minepedro/testes/docs/avaliacao-carrinho.md

# Avaliação do carrinho (Mercado Livre)

Feita só pelos nomes dos anúncios: o Mercado Livre bloqueia a leitura das páginas
daqui, então **não confirmei conteúdo nem preço de cada item**. Total do carrinho
informado: R$ 1.792,47 (sem o TPU e sem o kit de bornes banana, que ficaram desmarcados).

Já tem: ferro de solda e estanho.

## Tirar
| Item | Motivo |
|---|---|
| Ferro de solda Exbom 60W | Você já tem. Se o seu for sem ajuste de temperatura, 60W ajustável ainda é bom, mas não é necessário. |
| Estanho 63/37 0,5 mm | Você já tem. Confira só se é com fluxo e fino (0,5 a 0,8 mm). |
| Luminária com lupa e ring light | Repete a lupa com garras (terceira mão). Fique com uma. |
| Analisador lógico 8 canais | Não é necessário agora. Só vale se o SPI ou o I2S falharem de um jeito que o multímetro não explica. Dá para comprar depois. |
| Kit estilete de precisão 13 peças | Sobrepõe o kit de limas e o de chaves. Opcional. |
| Tapete antiestático | Conforto, não necessidade. Opcional. |

## Manter (correção)
Amplificador MAX98357A, alto-falante 3W e capacitor 470 µF **ficam**. O Pedro não quer voz falada, mas quer som opcional (decisão 18). O capacitor vai no amplificador.

## Conferir antes de pagar
1. **Kit 120 jumpers:** a montagem precisa de **13 macho-fêmea** (tela) e **8 macho-macho**. Muito kit de 120 traz só macho-macho. Se o anúncio não listar as três pontas, pergunte ou troque.
2. **Placa ilhada 9×15 cm:** a caixa foi desenhada para 80×60 mm. Ela serve, mas precisa ser cortada (riscar com estilete e quebrar na quina da mesa, ou serra fina). Se achar 6×8 cm, é mais simples.
3. **Parafuso Allen M3×16:** precisa de chave **Allen 2,5 mm**. O kit de chaves de precisão pode não ter. Confira, senão compre uma chave Allen avulsa.
4. **Fluxo em pasta Mechanic UV 559:** é fluxo para solda; vale conferir se é do tipo "sem limpeza". Se não for, precisa de álcool isopropílico para limpar.
5. **Termo-retrátil:** precisa de calor (isqueiro, pistola de ar quente). O ferro não serve bem.
6. **Voltagem:** o carrinho tem item de 127 V (o ferro). Se tirar o ferro, sem problema; confira a voltagem do carregador e de qualquer outro item ligado na tomada.

## Falta
| Item | Para quê |
|---|---|
| Álcool isopropílico | Limpar o fluxo depois de soldar; sem ele a placa fica pegajosa e pode dar fuga. |
| Chave Allen 2,5 mm | Parafusos M3 da caixa (se o kit de chaves não tiver). |
| Cabo USB-C 90° (opcional) | Se a saída lateral da caixa ficar apertada. |

Para a perfboard (Parte 2 do manual), o que já está no carrinho cobre: barra fêmea (soquetes do ESP32 e da tela), barra macho, fio 26 AWG, ferro, estanho, fluxo, sugador e terceira mão.

## Quase tudo de "montagem" é opcional
- **Capacitores cerâmicos 100 nF (kit de 100):** extra do manual, off por padrão; 100 unidades é muito, mas custa pouco.
- **Botões táteis 6×6:** extra opcional.
- **Insertos M3 e parafusos:** só quando for montar a caixa; os kits (50 e 100) são grandes, mas baratos.
- **Kapton, limas, fio vermelho de 5 m:** sobra, mas são baratos e úteis na caixa e na perfboard.
