minepedro/testes/docs/compras-online.md

# Lista de compras online (Mercado Livre)

Filtre por **Full** ou entrega no dia seguinte e confira a data para o seu CEP.

## Prioridade 1: o que não funciona sem
- [ ] [ESP32-S3 N16R8](https://lista.mercadolivre.com.br/esp32-s3-n16r8) (qtd 2)
- [ ] [Tela 3,5" ST7796 SPI touch](https://lista.mercadolivre.com.br/tela-3.5-polegadas-st7796-spi-touch) (qtd 1)
- [ ] [Microfone INMP441](https://lista.mercadolivre.com.br/inmp441) (qtd 2)
- [ ] [Cabo USB-C de dados](https://lista.mercadolivre.com.br/cabo-usb-c-dados) (qtd 2)

## Prioridade 2: montagem
- [ ] [Protoboard 830 + jumpers](https://lista.mercadolivre.com.br/kit-protoboard-830-jumpers) (jumpers macho-macho **e macho-fêmea**; a montagem usa uns 22)
- [ ] [Barra de pinos macho](https://lista.mercadolivre.com.br/barra-de-pinos-macho) (para a tela, se vier sem pinos soldados)
- [ ] [Inserto de latão M3](https://lista.mercadolivre.com.br/inserto-latao-m3)

## Opcional: som (bipes e alertas, sem voz; decisão 18)
- [ ] [Amplificador MAX98357A](https://lista.mercadolivre.com.br/max98357a) (qtd 2)
- [ ] [Alto-falante 4 ohm 3 W 40 mm](https://lista.mercadolivre.com.br/alto-falante-4-ohm-3w-40mm) (qtd 2)
- [ ] [Capacitor 470 uF 10 V](https://lista.mercadolivre.com.br/capacitor-eletrolitico-470uf-10v)

## Prioridade 3: ferramentas
- [ ] [Multímetro](https://lista.mercadolivre.com.br/multimetro-digital-minipa)
- [ ] [Estanho 63/37](https://lista.mercadolivre.com.br/estanho-63-37)
- [ ] [Fluxo de solda](https://lista.mercadolivre.com.br/fluxo-de-solda-pasta)
- [ ] [Malha dessoldadora](https://lista.mercadolivre.com.br/malha-dessoldadora)
- [ ] [Kit de alicates](https://lista.mercadolivre.com.br/kit-alicate-eletronica)
- [ ] [Terceira mão com lupa](https://lista.mercadolivre.com.br/terceira-mao-solda-lupa)

## Conferir no anúncio antes de pagar
1. **ESP32:** diz "N16R8" (ou N8R8) e módulo ESP32-S3-WROOM-1. Só "ESP32 S3" pode vir sem PSRAM.
2. **Tela:** diz SPI, 480x320 e ST7796 (ou touch capacitivo). "Shield Arduino Uno" é a errada. Prefira o anúncio que informa o **chip do touch** (FT6336 ou GT911) e mostra a **ordem dos pinos**; se não mostrar, pergunte ao vendedor.
3. **Pinos da tela:** pergunte se vem **com pinos soldados** e se aceita **3,3 V**.
4. **Vendedor:** reputação verde ou MercadoLíder, com avaliações recentes confirmando que funciona.
5. **Frete:** comprar as placas do mesmo vendedor para chegar tudo junto.
