minepedro/testes/hardware/caixa/planta-caixa.html

Mascote do Claude · caixa Mini Mac

# Planta da caixa

A caixa inteira em escala, com as peças de verdade dentro: a tela, a placa ilhada com o ESP32, o alto-falante, o microfone, o botão e o LED. Confira a disposição e me diga o que mudar. Só depois eu modelo.

## De frente

A tela fica recuada numa moldura chanfrada, como no Macintosh. Embaixo, no queixo: o LED à esquerda, a gradezinha do microfone no meio e o botão à direita. O tracejado é o que fica escondido.

A janela fica no meio da caixa: a tela anda 2,3 mm para a direita porque a parte que acende não é centrada no vidro.

## Em corte, de lado

Cortada no meio, com a frente à esquerda. A placa ilhada fica deitada na bandeja, atrás e abaixo da tela; o alto-falante fica em cima, virado para a grade do topo.

Os jumpers da tela e do amplificador ficam em pé até 55,5 mm; a tela começa em 58 e o alto-falante em 106,6, então nada encosta.

## Vista de cima, na altura da placa

A placa vira com a linha V para a frente: os soquetes da tela e do microfone ficam perto da tela, e o USB-C “USB” fica na lateral direita.

Lateral direita: a fenda do cabo e a ventilação.

## Peças

Peça | Tamanho | Como imprime
Corpo: frente, topo e laterais numa peça só, com a moldura da tela, a grade do alto-falante, a fenda do USB e os trilhos da bandeja | 110 × 130 × 112 | Frente na mesa (sai fosca na texturizada), sem suporte. A peça mais demorada.
Bandeja: o fundo com os pininhos da placa e a tampa de trás, com ventilação; desliza por trás e prende com 2 parafusos M3 | 105 × 110 × 128 | Fundo na mesa, tampa em pé.
Moldura de trás da tela, como a do teste, com os 4 insertos em cima e embaixo da tela | 100 × 70 | Deitada, torres para cima.
Tecla do botão, suporte do microfone com anel de vedação, anel do alto-falante e berço do amplificador | pequenas | Juntas numa mesa; a tecla pode ir em branco.
Compras: 6 insertos M3, 4 pezinhos de borracha. Os parafusos M3 × 19 servem. | – | –

## Para você confirmar

1. Tamanho: 110 de largura, 112 de fundo e 130 de altura, perto dos 11 × 12 × 13 cm do desenho de antes.
2. Tela reta, recuada 3 mm numa moldura chanfrada. Inclinar a tela deixa a caixa mais funda e difícil de imprimir.
3. Corpo numa peça só, sem emenda na frente. A placa entra por trás, na bandeja, e sai deslizando depois de tirar o cabo USB.
4. Placa virada com a linha V para a frente, com o USB na lateral direita, a 23,5 mm do chão.
5. Insertos da tela em cima e embaixo dela, não nas laterais como no teste, para a caixa caber em 11 cm de largura. O teste continua valendo para provar o encaixe e o aperto.
