minepedro/testes/hardware/caixa/caixas-retro.html

# Caixas retrô do mascote

Dois estilos para imprimir na Bambu Lab A1, com a tela de 3,5" na frente e a placa escondida atrás. Só o visual, para escolher. As medidas são aproximadas e a gente acerta com as peças na mão.

## Mini Mac com LED, botão e extras

Os fios ficam todos por dentro e a tela fica presa atrás da moldura pelos 4 furos dela, com parafusos M3. Toque nos estados embaixo do desenho, ou use o botão laranja do próprio desenho: segure para falar e solte para mandar. Se ele estiver cochilando, 1 clique acorda.

1. 1
  LED de status, embaixo à esquerda, com uma tampinha de PLA branco que espalha a luz.
2. 2
  Botão, na frente, à direita da grade. 1 clique acorda o mascote quando ele está cochilando. Segure, fale e solte para mandar. Os pezinhos de borracha seguram a caixa quando você aperta, e o programa corta o primeiro pedacinho do áudio para não gravar o clique.
3. 3
  Alto-falante, embaixo da grade redonda do topo: um “plim” quando o Claude termina.

Ver o LED:

## Os botões que você comprou servem?

A foto ou o link do anúncio não chegaram aqui, então desenhei os tipos mais comuns. Qualquer um serve se for de pulso (solta sozinho quando você tira o dedo; no anúncio aparece como “momentâneo” ou “NA”). Botão com trava não serve. Todos ligam com 2 fios: um no GPIO 21 e outro no GND.

## Onde liga cada extra

Extra | Pino do ESP32 | Furo na placa | Mais
LED RGB (WS2812) | GPIO 47 | B7 | 3V3 e GND
Botão (acordar e falar) | GPIO 21 | B6 | GND
Alto-falante (MAX98357A) | GPIO 15, 16 e 18 | L16, L15 e L13 | 5V e GND

O LED e o botão usam pinos livres. O alto-falante divide o 15 e o 16 com o microfone: é só soldar mais um fio no mesmo furo. Correção da minha mensagem anterior: o GPIO 18 já está reservado para o alto-falante, então o LED vai no 47.

## Mini Macintosh

uns 11 × 12 × 13 cm (largura × profundidade × altura)

- Tela inclinada de leve, numa moldura funda, como os computadores dos anos 80.
- No “queixo”, embaixo da tela, uma gradezinha com o microfone logo atrás.
- O cabo USB sai por uma fenda na lateral, perto do chão.
- Os furinhos no topo ventilam o ESP32 e depois servem para o alto-falante.
- Base com degrau e pezinhos de borracha.

Filamento:

## TV de tubo

uns 15 × 10 × 18 cm com as pernas e a antena

- Tela com cantos bem arredondados e linhas de varredura, como tubo de imagem.
- Dois botões giratórios do lado: hoje enfeite, depois podem trocar de sessão de verdade.
- A grade embaixo dos botões já fica pronta para o alto-falante.
- Antena “orelha de coelho” de arame ou impressa, e pernas palito abertas.

Filamento:

## Mini Macintosh por dentro

A placa vai deitada numa bandeja no fundo, que desliza para fora por trás (como o chassi do Macintosh original). O microfone sai da placa por 6 jumpers curtos e fica preso atrás da gradezinha do queixo, vedado, virado para quem fala.

Corte de lado (a frente à esquerda). Medidas em mm, aproximadas.

A bandeja vista de cima (a frente embaixo), com a placa no lugar.

## Por que assim

- Microfone: encostado num furinho com uma arruela de EVA em volta, o som vai direto ao microfone, sem pegar o eco de dentro da caixa. Com os jumpers, a placa pode ficar onde for melhor.
- Placa deitada: a fileira com os soquetes da tela e do microfone fica para a frente, então os jumpers da tela sobem curtos até ela e os do microfone ficam com uns 5 cm.
- USB: o USB-C do ESP32 (a porta “USB”, do lado da linha L; a COM queimou) fica na beirada da placa; uma fenda na lateral, alinhada com ele, deixa gravar sem abrir nada.
- Calor e antena: o ar quente sobe para os furinhos do topo; a ponta da antena do ESP32 fica livre, sem metal perto.
- Montagem: tudo é montado na bandeja aberta, liga os jumpers, desliza para dentro e 2 parafusos atrás seguram.

## Para eu desenhar as peças de verdade, preciso de

- Os pininhos do microfone saem do mesmo lado do furinho do som ou do lado do chip?
- A placa ilhada tem furos nos cantos? Qual o diâmetro e a distância entre eles?
- A altura da placa montada: da parte de baixo das soldas até o topo do ESP32 encaixado.
- A tela: largura e altura da placa vermelha, onde fica a área da imagem e de que lado fica o conector de 14 pinos.

Para comprar: 6 jumpers macho-fêmea de 10 cm (microfone) e uma folha fina de EVA ou borracha (vedação do microfone).

As duas cabem inteiras na mesa da A1 (256 mm). A frente é impressa deitada, com a face da tela virada para a mesa texturizada, para a moldura sair lisa. As cores são as de filamentos PLA comuns.
