minepedro/testes/hardware/caixa/modelo/caixa-3d.html

Mascote do Claude · caixa v1

# Caixa Mini Mac em 3D

Gire com um dedo, aproxime com dois e toque numa peça para ver o que ela é. É o mesmo arquivo que vai para a impressora, com as peças de verdade (tela, placa, alto-falante) dentro para conferir.

Carregando o modelo (1 MB)…

3/4 Frente Lado do USB Trás Cima

110 × 112 × 130 mmgrade de 10 mm

Corpo transparente Peças de verdade MontadaSeparada

Toque numa peça

Com o corpo transparente dá para tocar nas peças de dentro.

## Ainda não imprima a caixa

Faltam duas coisas. A primeira é o resultado do terceiro teste da tela, com a placa apoiada só nos 4 cantos. A segunda são três medidas que ainda são chute. Como a entrada do USB-C é embutida e o plugue entra inteiro na lateral, o túnel precisa das medidas reais.

Plástico do plugue USB-C: largura × altura, comprimento | 12 × 6,5, 20
Medida J: da borda de trás da placa até o meio do USB | 25,1
Plaquinha do amplificador | 18 × 19,3

Preencha em Medidas do Mini Mac (https://claude.ai/artifact/MskuowJLJFxwNJLMU6zfgv). O comprimento do plugue também move a placa na bandeja, então o corpo e a bandeja esperam essas medidas.

## As peças

Para imprimir

De verdade, só para conferir

## O que foi conferido

Medido nos arquivos gerados, com as peças montadas no computador.

- As 5 peças estão fechadas, cada uma inteira, sem pedaço solto.
- Montadas, nenhuma invade outra nem as peças de verdade.
- A bandeja entra por trás com a placa, o ESP32 e os jumpers em cima sem bater em nada.
- A chave de fenda alcança os 4 parafusos da tela por trás, com o alto-falante e o amplificador já no lugar.
- Os parafusos de 19 mm param antes do fundo dos furos: sobram 0,4 mm na tela e 0,9 mm atrás.
- Imprime sem suporte. Os únicos pontos no ar são furos deitados (o maior é o do USB, com 7 mm de altura), as pontes de 1,8 mm das fendas e um degrau de 1 mm em volta da janela da tela.

O que não deu para conferir

- Não fatiei no Bambu Studio: o tempo, o filamento e as pontes você confere lá.
- Encaixe do plugue, dos insertos e do alto-falante só a impressão mostra.

## Como vai imprimir

caixa-corpo.3mfO corpo já deitado com a frente na mesa: a frente sai lisa, com o acabamento da placa de impressão.

caixa-bandeja-e-pecas.3mfA bandeja deitada, a moldura da tela, a tecla (com a face na mesa) e a tampa do microfone.

Para montar

- 6 insertos M3 e 6 parafusos M3 × 19: 4 na tela e 2 na tampa de trás.
- Fita dupla-face para o alto-falante, embaixo da grade do topo.
- Um anel de EVA de 1 mm entre a grade e o microfone.
- 4 pezinhos de borracha colados embaixo da bandeja.
