minepedro/testes/docs/decisoes.md

# Decisões

Formato: pergunta, resposta, motivo.

## 1. Como conversa com o mascote?
**Voz + tela touch.** Microfone e alto-falante para conversar, tela touch para navegar nas sessões.

## 2. Onde roda a inteligência?
**ESP32-S3 como terminal + ponte rodando na VPS (nuvem).** O mascote só cuida de tela, touch, mic e alto-falante; a ponte conversa com o Claude, lê as sessões e faz fala/transcrição.
Motivo: já existe servidor ligado 24h, então não precisa de Raspberry Pi (mais caro, esquenta).

## 3. Quais sessões o mascote mostra?
**As duas: Claude Code (cc.remote) e chats do claude.ai.**
- Claude Code: a ponte lê direto na VPS (fonte oficial/estável).
- claude.ai: fonte de dados ainda em aberto. Não há API oficial para conta pessoal; a Compliance API é só Enterprise. Alternativas: wrapper não oficial por cookie (frágil), export manual, extensão de Chrome.
- A fonte dos chats é software (ponte), não muda o hardware.

## 4. Como tratar os chats do claude.ai?
**v1 só Claude Code; claude.ai fica para a v2.** Método da v2 (cookie, export, extensão ou Compliance API) será escolhido depois, sem impacto no hardware.

## 5. Placa pronta ou peças avulsas?
**Peças avulsas, compradas na Santa Ifigênia.** ESP32-S3 (com PSRAM) + tela touch + microfone I2S + amplificador + alto-falante. Carcaça impressa na Bambu A1.

## 6. Qual tela?
**3,5" touch, 480x320.** Maior e mais legível para lista de sessões.
Nota de compra: preferir controlador ST7796 (RGB565, mais rápido) ao ILI9488 (18 bits, mais lento no SPI). Confirmar o tipo de touch (resistivo XPT2046 ou capacitivo) na loja.

## 7. Como acorda o mascote?
**Toque na tela (push-to-talk) na v1; palavra de ativação depois.** O ESP32-S3 suporta as duas, então o hardware não muda.

## 8. O que acontece quando fala com ele?
**B) Claude do mascote que lê e responde, e também envia comandos e aprova permissões nas sessões.**
Risco registrado: erro de transcrição de voz pode aprovar ação errada. Mitigação a definir na decisão 9.

## 9. Confirmação antes de agir
**Toque na tela para confirmar, por enquanto (provisório).** Tela mostra exatamente a ação; só executa quando o Pedro toca em Aprovar. Rever o nível de confirmação (sempre vs só ações de risco) antes da v1 final.

## 10. Alimentação
**USB-C na tomada na v1.** Bateria fica para uma v2; carcaça da v1 não precisa reservar espaço.

## 11. Voz (STT e TTS)
**Decidir depois.** Não afeta a compra de hardware. Sugestão para a ponte: manter STT e TTS atrás de uma interface simples, para trocar de provedor sem reescrever.
Atualização: a saída por voz (TTS) foi descartada na decisão 16. Só a entrada (STT) segue em aberto.

## 12. Como o mascote é fisicamente?
**É o mascote do Claude** (assumido: o bichinho laranja pixelado do Claude Code, conhecido como Clawd; confirmar). Personagem com corpo impresso na A1, tela 3,5" exibindo o personagem animado.
Nota: uso pessoal sem problema; se um dia for vender, a marca/personagem pertence à Anthropic.

## 13. Onde fica a tela no personagem?
**O mascote vive dentro da tela.** A tela exibe o mascote animado; a carcaça impressa é uma caixa/moldura simples ao redor, sem corpo mecânico.

## 14. Orçamento da v1
**Sem teto definido.** Priorizar qualidade (touch capacitivo, controlador ST7796, alto-falante decente) e comprar peças reserva.

## 15. Onde comprar
**Tudo online com entrega rápida** (Mercado Livre e similares), em vez da Santa Ifigênia, porque o Pedro está na Zona Sul e não há loja física confirmada aberta no sábado. Conferir na página do anúncio: N16R8, controlador ST7796, I2S, vendedor bem avaliado e prazo de entrega para o CEP.

## 16. Como o mascote responde?
**Por texto, na tela.** Sem voz de saída (TTS) na v1. A resposta é escrita no rodapé com a boca do mascote mexendo; um toque abre a resposta inteira para ler e rolar. Cada sessão guarda a última troca.
Impacto: o alto-falante e o amplificador MAX98357A deixam de ser necessários na v1 (ficam opcionais, para uma v2 com voz). O microfone continua, porque a entrada segue sendo por voz (push-to-talk).

## 17. Formato da caixa
**Opção A: cunha de duas peças** (moldura frontal inclinada 15° + tampa traseira, quatro pés laranja). Comparada com moldura com pé (B) e tela num pescoço (C); o pescoço com base fica como ideia para uma v2 com bateria.
A modelagem fica para depois, quando as peças chegarem e as medidas forem confirmadas com o paquímetro. Os desenhos e as medidas de projeto estão em `hardware/caixa-desenho.html`. Para a caixa, a placa universal passa a ser de **6 × 8 cm** (a de 9 × 15 cm era grande demais).

## 18. Som (sem voz)
**Sem voz falada, mas com som opcional.** O mascote faz sons curtos (bipes e melodias, como aviso de que uma sessão pede aprovação), gerados pelo próprio firmware. O MAX98357A e o alto-falante entram na montagem como **extra opcional**, não como peça de v2. Dá para montar com som mudo e ligar depois. Os pinos já estavam reservados (DIN no GPIO 18, BCLK e WS compartilhados com o microfone).
Compra: ficam o amplificador (2), o alto-falante (2) e o capacitor 470 µF no carrinho. Isso corrige a avaliação do carrinho que sugeria tirar esses itens.
Risco: compartilhar BCLK e WS entre microfone e amplificador (mesma porta I2S, entrada e saída) ainda não foi testado na placa.

## 19. Botão físico opcional
**GPIO 21 para o GND**, com o pull-up interno do ESP32 (extra A da Parte 2). Serve de apertar-para-falar ou mudo, sem depender da tela. O GPIO 21 fica no lado J3 da placa, longe dos pinos reservados (USB 19/20, flash/PSRAM 26–37).

## 20. Onde rodam as sessões que o mascote controla
**Na VPS, com o Claude Code e a assinatura do Pedro (`claude setup-token`), não na nuvem do claude.ai/code.**
Motivo: não há API documentada para um programa de fora ver ou responder pedidos de permissão das sessões da nuvem. Rodando na VPS, a ponte recebe cada pedido (comando, edição, pergunta de opção) antes de executar e espera o toque no mascote.
Desejo: ver e usar as mesmas sessões também pelo app do Claude (Remote Control). **A confirmar em teste**: o modo `claude -p` com hook "defer" (que pausa e retoma) não é uma sessão contínua, então pode não aparecer no app. Alternativa a testar: sessão interativa com Remote Control e um hook PreToolUse que espera a decisão do mascote por alguns minutos e, sem resposta, devolve "ask" (o pedido cai no app).

## 21. O que o mascote é
**Um controle remoto do Claude Code com voz e corpo.** Tudo o que o app do Claude faz numa sessão do Remote Control na VPS, o mascote também deve fazer: ver as sessões, criar sessão escolhendo repositório e branch, aprovar e recusar, escolher opções, aprovar planos e mandar mensagens. A diferença é que o mascote é controlado por voz e tem um corpo.
Respostas de texto livre dependem da voz (microfone).

## 22. Repositórios na VPS
**Todos os repositórios do GitHub do Pedro ficam disponíveis na VPS, pelo GitHub CLI (`gh`).** A ponte lista os repositórios e as branches com `gh` e clona cada um na primeira vez que uma sessão for aberta nele (não clona tudo de uma vez, para não encher o disco). O `gh` também serve de credencial do git para commit e push.

## 23. Comandos perigosos
**Só pelo app.** O mascote aprova os pedidos comuns, mas, quando o pedido é perigoso, mostra um aviso ("aprove pelo app") e não oferece o botão Aprovar. Lista inicial de perigosos: `rm -rf`, `git push --force`/`-f`, `git reset --hard`, apagar branch remota, deploy/publicação, `sudo`, mudanças em `.env` ou credenciais, e qualquer comando com `curl ... | sh`. A lista fica na ponte e pode ser ajustada.
Revisado (2026-10-15): o "ask" forçado vale só nas sessões criadas pelo mascote; nas sessões do Pedro (abertas pelo app ou à mão) decide o modo Automático. Se uma delas pedir permissão para um perigoso, o mascote mostra "aprove pelo app", sem botão.

## 24. Sessões da nuvem no mascote
**O mascote mostra as sessões do Remote Control (VPS) e também as da nuvem (claude.ai/code).**
Na lista, as da nuvem levam um ícone diferente. Nelas o mascote mostra estado e última resposta, manda mensagens (`claude -p ... --cloud`, documentado) e, **como recurso experimental desligável**, responde pedidos: aprovar/recusar, escolher opções (inclusive várias) e aprovar planos.
Esse recurso usa uma API interna não documentada do Claude Code (testado em 2026-10-11; resultados em `software/bridge/cli/README.md`): pode quebrar sem aviso. Se falhar ou estiver desligado, o pedido aparece como aviso "responda pelo app". Na nuvem não há "sempre permitir" (não comprovado), e pedidos perigosos continuam só pelo app, como na VPS (decisão 23).
Revisado em 2026-10-11: antes, a nuvem era só para ver.

## 25. Correções das decisões 20 e 22
- Decisão 20: as sessões da VPS usam o **login completo do claude.ai** na CLI (`claude` → `/login`), não `claude setup-token` (esse token só serve para chamadas ao modelo; o Remote Control exige o login).
- Decisão 22: "todos os repositórios" inclui os das organizações do Pedro (ex.: `byesolutions`), listados à parte com `gh repo list <org>`.
- Mensagens novas para sessões da VPS usam `tmux send-keys` (não documentado), só com a sessão parada e confirmando a chegada pelo hook `UserPromptSubmit`.

## 26. Voz
**Segurar a tela, falar e soltar. O ESP32 grava PCM 16 kHz e manda para a ponte, que transcreve com Whisper local na VPS (faster-whisper, modelo small, portugues).** Gratis e privado: o audio nao sai do servidor.
O texto aparece na tela antes de ir para o Claude (Enviar ou Descartar), por causa de erros de transcricao (risco da decisao 8).
- Dentro de uma sessao: o texto vira mensagem para ela.
- Na tela inicial: o texto vira a tarefa de uma sessao nova; depois escolhe repositorio e branch.

## 27. Camarim: acessórios e animações
**O mascote ganha acessórios em camadas e animações ligadas aos eventos das sessões, escolhidos numa tela "Camarim" no próprio aparelho.**
- Camadas (uma peça de cada): cabeça, olhos, bigode, boca, peito, mão, cor do corpo e fundo. A escolha fica gravada na NVS do ESP32.
- Animações: comemorar (sessão concluída), dancinha (todas concluídas), pedir aprovação, aprovado, recusado, tonto (erro), trabalhando, ouvindo, cochilo (10 min parado), cócegas (toque curto no corpo) e arrumar o bigode (sozinho, de vez em quando). No Camarim, qualquer uma pode ser tocada à mão.
- Tudo é desenhado só com retângulos, como o corpo. A prévia em `docs/camarim/index.html` é a especificação (formas, cores e tempos), e `docs/camarim/PROMPT-firmware.md` é o pedido para levar isso ao firmware.
- Firmware feito (`firmware/mascote`): acessórios, 11 animações com gatilhos reais, tela Camarim (cabide no canto superior direito) e escolha na NVS; compila sem avisos novos, ainda não testado na placa.

## 28. Caixa Mini Mac (substitui a 17)
**A caixa é um Mini Macintosh de uns 11 × 12 × 13 cm, no lugar da cunha de duas peças.** A placa ilhada (80 × 60) fica deitada numa bandeja que sai por trás; o microfone vai atrás da grade do queixo por 6 jumpers, o alto-falante embaixo da grade do topo, o botão na frente à direita da grade e um LED WS2812 de status.
- A tela fica presa por uma moldura de trás com 4 parafusos M3 em insertos de calor, por fora da placa vermelha. Os furos da tela só recebem pininhos, porque do furo até o vidro sobram menos de 3 mm.
- Antes da caixa, uma peça de teste prova o encaixe e a fixação da tela. Medidas, arquivos e pendências em `hardware/caixa/README.md`.
