minepedro/testes/hardware/caixa/medidas-mini-mac.html

Mascote do Claude · caixa Mini Mac

# Medidas do Mini Mac

Para eu desenhar a caixa no tamanho certo, meça cada peça com o paquímetro, em milímetros. Toque numa letra do desenho para ir direto ao campo dela. Tudo salva sozinho e eu leio daqui: quando terminar, é só me avisar no chat.

Pode usar vírgula (98,5). Sem paquímetro, uma régua serve: escreva o que der. Se não souber alguma, deixe em branco.

Os desenhos abrem em “Como eu entendi”: em escala, com as suas medidas. Azul é medida sua (toque no número para corrigir), cinza é conta minha e roxo é suposição. Em “Onde medir” estão as letras de cada medida.

0 de 0

Abrindo o caderno de medidas…

## Terminou?

Me avise no chat que as medidas estão prontas. Se aparecer “salvo só neste aparelho” lá em cima, copie o resumo e cole no chat.

Copiar resumo

Ver o resumo
