minepedro/testes/hardware/caixa/modelo/caixa-tecla.step

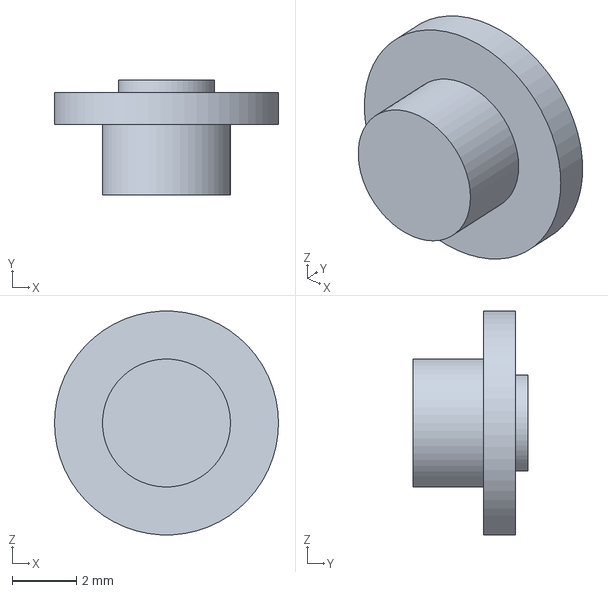
[picture p1: CAD file, 2026-10-19]
hardware/caixa/modelo/caixa-tecla.step
7.00 x 3.60 x 6.99 mm
