minepedro/testes/hardware/caixa/teste-tela/teste-tela-frente.step

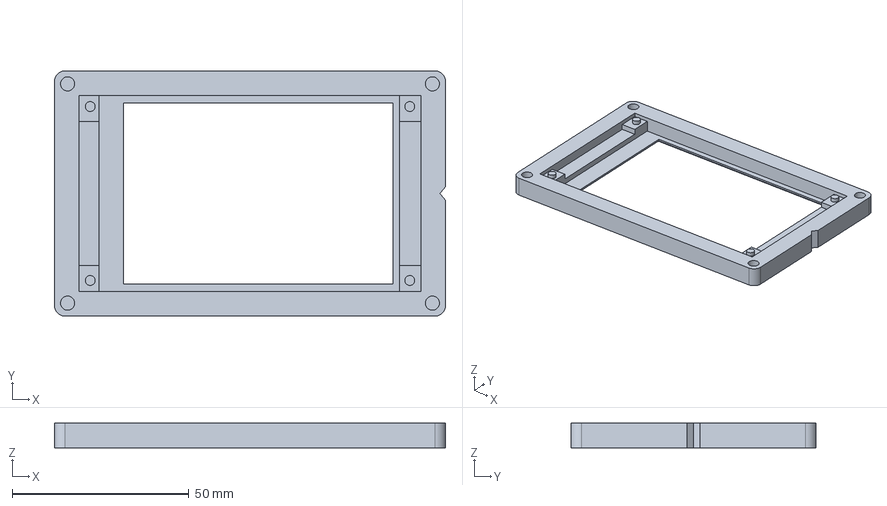
[picture p2: CAD file, 2026-10-19]
hardware/caixa/teste-tela/teste-tela-frente.step
110.6 x 69.4 x 7.00 mm
