minepedro/testes/hardware/caixa/modelo/caixa-bandeja.step

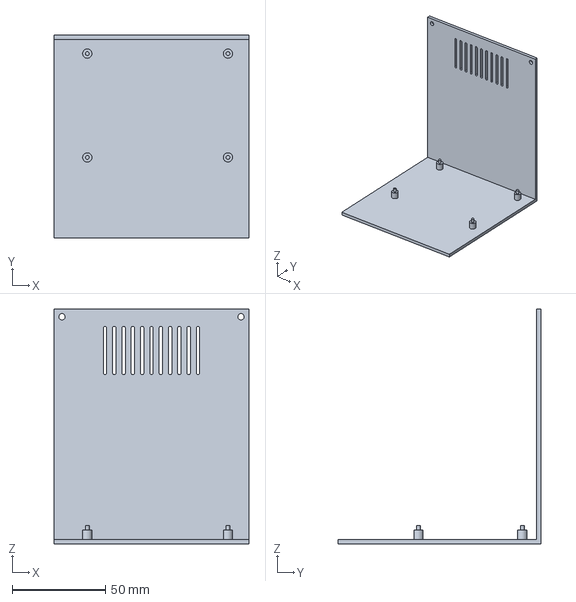
[picture p3: CAD file, 2026-10-19]
hardware/caixa/modelo/caixa-bandeja.step
104.6 x 109.3 x 126.3 mm
