minepedro/testes/hardware/caixa/teste-tela/teste-tela-tras.step

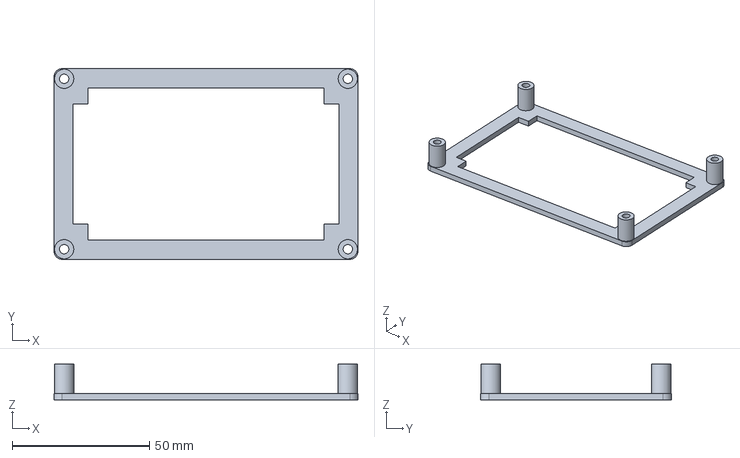
[picture p4: CAD file, 2026-10-19]
hardware/caixa/teste-tela/teste-tela-tras.step
110.6 x 69.4 x 13.0 mm
