minepedro/testes/hardware/caixa/modelo/caixa-bandeja-e-pecas.3mf

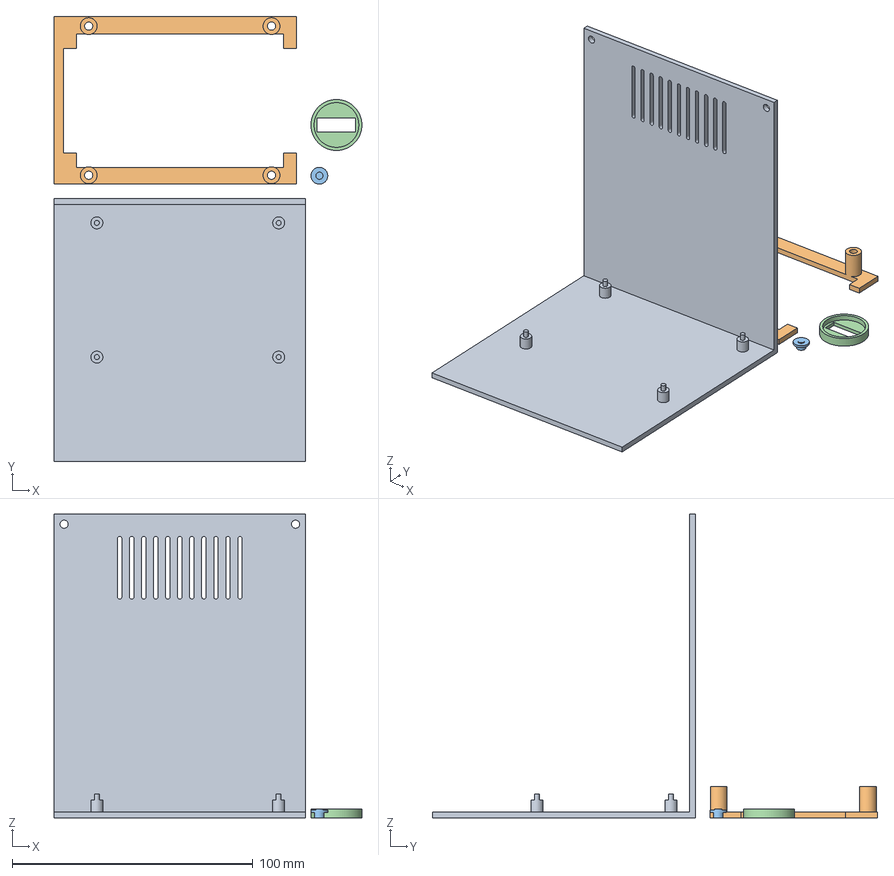
[picture p5: CAD file, 2026-10-19]
hardware/caixa/modelo/caixa-bandeja-e-pecas.3mf
128.0 x 185.0 x 126.3 mm
bandeja
moldura da tela
tecla
tampa do microfone
