minepedro/testes/hardware/caixa/teste-tela/teste-tela.step

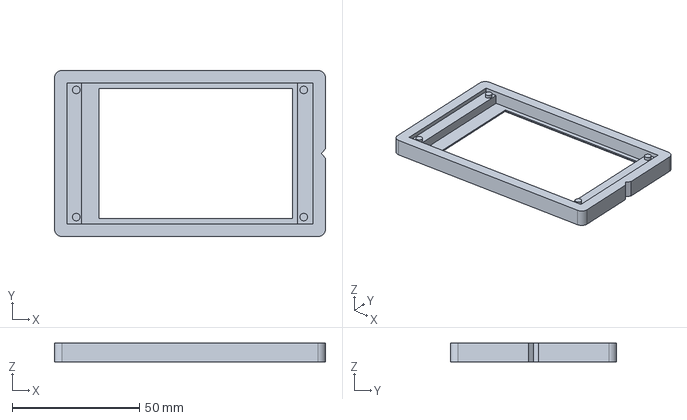
[picture p6: CAD file, 2026-10-19]
hardware/caixa/teste-tela/teste-tela.step
106.6 x 65.4 x 7.40 mm
