minepedro/testes/hardware/caixa/modelo/caixa-corpo.step

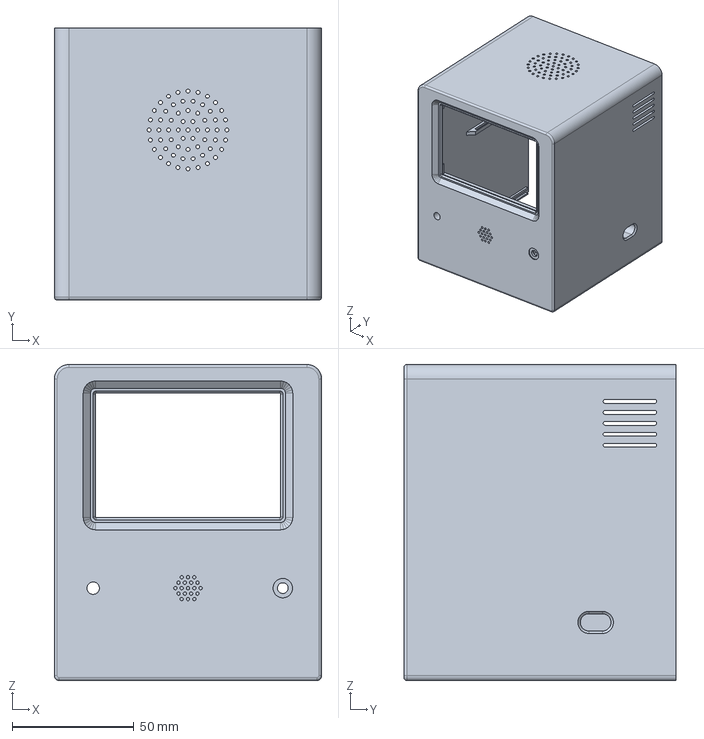
[picture p7: CAD file, 2026-10-19]
hardware/caixa/modelo/caixa-corpo.step
110.0 x 112.0 x 130.0 mm
