minepedro/testes/hardware/caixa/modelo/caixa-tampa-do-microfone.step

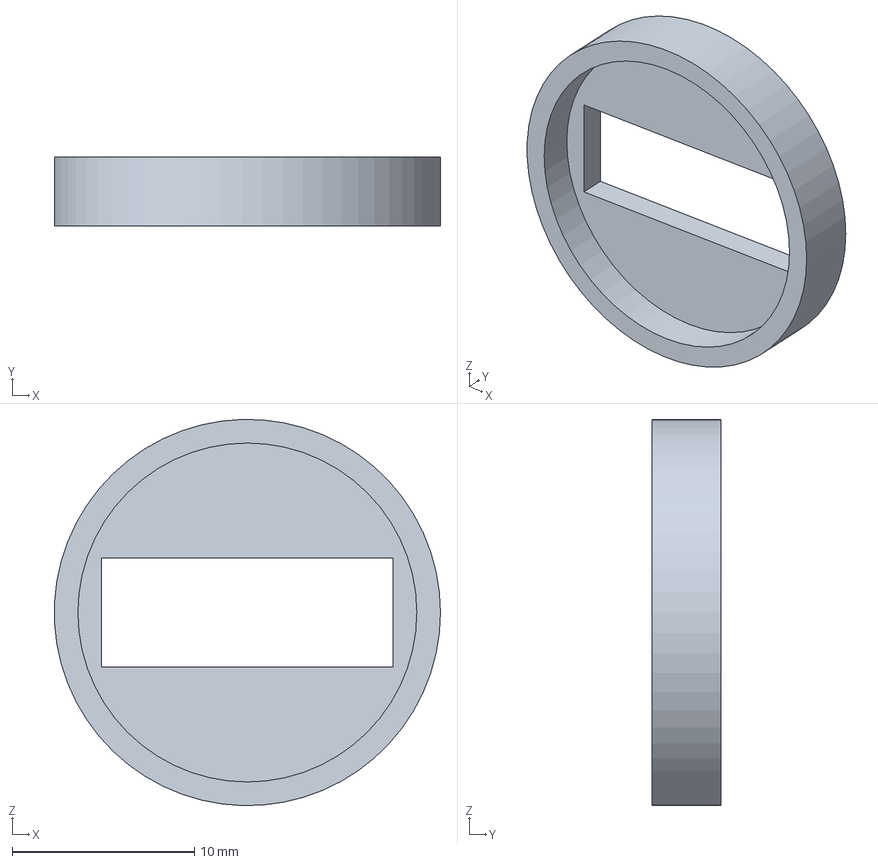
[picture p8: CAD file, 2026-10-19]
hardware/caixa/modelo/caixa-tampa-do-microfone.step
21.2 x 3.80 x 21.2 mm
