minepedro/testes/hardware/caixa/modelo/caixa-moldura-da-tela.step

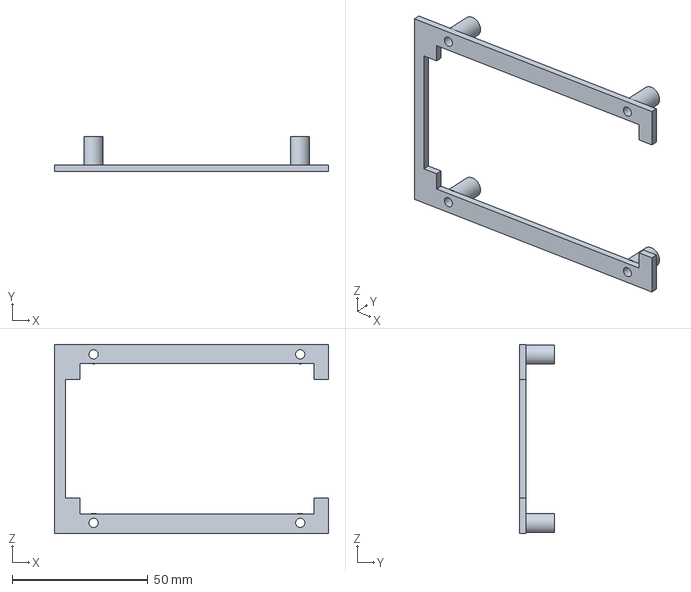
[picture p9: CAD file, 2026-10-19]
hardware/caixa/modelo/caixa-moldura-da-tela.step
100.8 x 13.0 x 69.7 mm
