minepedro/testes/(list of files, cad)

Other CAD files:
hardware/caixa/modelo/caixa-corpo.3mf
hardware/caixa/teste-tela/teste-tela.3mf
