minepedro/testes/hardware/caixa/teste-tela/croqui.html

Mascote do Claude · caixa Mini Mac

# Peça de teste da tela

Antes da caixa inteira, duas peças pequenas para provar o encaixe e a fixação da tela: a moldura da frente, com a janela, o bolso do vidro, 4 pininhos nos furos da tela e 4 insertos M3 nos cantos; e a moldura de trás, que aperta a placa com 4 parafusos M3. Esta é a terceira versão do teste: a placa apoia só nos 4 cantos e o encaixe dela tem 0,4 de folga de cada lado. Os arquivos já foram gerados com estas medidas e conferidos.

## O que muda no terceiro teste: apoio só nos 4 cantos

Você descobriu por que a placa não assentava: do lado dos pinos, as soldas do conector saem na frente da placa e batiam na faixa onde ela apoia. A largura não era o problema. Então mudam duas coisas. A placa passa a apoiar só nos 4 cantos, onde estão os pininhos, com o meio das duas faixas 2 mm mais fundo. E o encaixe da placa volta a ter folga pequena: 0,4 de cada lado, 96,8 em vez de 98,6. Em laranja, o rebaixo. Os arquivos já foram gerados com estas medidas e conferidos.

De frente, com a placa vermelha clarinha por cima e as soldas em cinza. O vidro, os pininhos e a janela continuam iguais.

Cortada ao comprido pela fileira de soldas, a metade de cima (a de baixo é igual), com a frente para baixo, como sai da impressora. A posição e a altura das soldas são estimativa.

Cortada atravessada na altura das soldas, ponta esquerda. O bolso do vidro continua com 2 mm de parede para segurar o vidro.

O mesmo corte na ponta direita. Aqui não tem solda, mas o rebaixo entra igual para os 4 cantos ficarem do mesmo jeito.

- Encaixe da placa: 96,8 de largura, com 0,4 de folga de cada lado. Em cima e embaixo continua 0,3.
- Apoios: 7 mm em cima e 7 mm embaixo, nos dois lados. Cobrem os apoios da moldura de trás (5,6), então o aperto passa reto pela placa.
- Rebaixo: 2 mm mais fundo, nos 40,8 mm do meio.
- Para medir com o paquímetro: quanto a solda mais alta sai da placa (estimei 1,5) e a distância da borda de cima da placa até a primeira solda (estimei uns 10). Se a primeira solda estiver a menos de 8 mm da borda, encurto os apoios.
- A moldura de trás não muda: qualquer uma das duas que você já imprimiu serve, porque ela aperta os cantos da placa e não depende da largura do encaixe. A caixa recebe as mesmas mudanças.

## De frente

Como você vai ver a peça, com o mascote em pé e os pinos da tela à esquerda. O tracejado é o que fica escondido atrás: os bolsos, o rebaixo das soldas, os pininhos e, em vermelho, os furos dos insertos. Medidas em mm.

A janela é a parte que acende com 0,5 mm a mais de cada lado, com um chanfro de 1 mm em volta.

## Moldura de trás

Um quadro de 2,4 mm que apoia nos 4 cantos da placa vermelha, bem em cima dos furos, e deixa o meio livre para o conector e os componentes. Os parafusos M3 passam pelas torres e entram nos insertos da frente, por fora da placa.

As torres têm 7 mm de largura e 13 mm de altura: com o M3 de 19 a ponta para antes de furar a frente. Com parafusos M3 × 8 elas não seriam necessárias.

## Em corte, pelos pininhos de cima

A peça cortada na linha dos furos de cima, com a frente para baixo, do jeito que ela sai da impressora. A tela aparece encaixada, transparente.

Ponta esquerda, lado dos pinos.

Ponta direita.

## De onde vem cada medida

O quê | Medida | Origem
Placa vermelha | 96 × 54,8 | sua 54,8 = 0,3 + 54,2 + 0,3
Encaixe da placa (por trás) | 96,8 × 55,4 × 1,4 | sua 0,4 de folga de cada lado na largura (a largura não era o problema) e 0,3 em cima e embaixo; a placa fica 0,2 para fora, para a moldura de trás apertar
Apoio da placa | 4 cantos de 7; o meio 2,0 mais fundo | seu teste as soldas do conector batiam na faixa onde a placa apoiava
Vidro: da borda da placa até o vidro | 6,1 esq. · 5,7 dir. · 0,3 cima e baixo | sua
Vidro: largura | 84,2 | sua fecha: 6,1 + 84,2 + 5,7 = 96
Bolso do vidro | 85,0 de largura, altura toda | seu teste 0,4 de folga de cada lado: o vidro entrou perfeito
Profundidade do bolso do vidro | 4,0 | conta 5,4 − 1,6 da placa = 3,8, mais 0,2 de folga
Furos da tela | Ø 3,6, a 1 mm da borda: 90,4 × 49,2 | sua antes você tinha medido 89,5 × 50
Pininhos | Ø 2,8 × 1,4 | escolha minha 0,4 de folga no furo; não passam da placa
Parte que acende | 75,2 × 50,2 | sua 2 mm do vidro na esquerda, em cima e embaixo; 7 mm na direita
Janela | 76,2 × 51,2 | escolha minha parte que acende + 0,5 de cada lado
Frente e chanfro da janela | 1,6 · 1 × 45° | escolha minha
Insertos | furo Ø 4,0 × 6,2, nos 4 cantos | suposição inserto M3 de 5,7 de comprimento e uns 4,6 por fora
Parafusos | M3 × 19 | seus por isso as torres de 13 mm na moldura de trás
Moldura de trás | 2,4 de espessura | escolha minha aperta só os cantos da placa
Borda em volta e peça | 7 · 110,6 × 69,4 × 7,0 | escolha minha 7 mm para caber o inserto nos cantos

## Como imprimir e montar

- Arquivo: teste-tela.3mf, com as duas peças já deitadas: a da frente com a face da tela na mesa, a de trás com as torres para cima. Arraste para a janela do Bambu Studio.
- Ajustes: PLA bege, camada de 0,2 mm, 4 paredes (firma o plástico em volta dos insertos), 15% de preenchimento, sem suporte.
- Insertos: com o ferro de solda a uns 220 °C, apoie o inserto no furo e deixe ele afundar sozinho, sem empurrar, até ficar rente. Embaixo do furo só tem 0,8 mm de frente: se forçar, aparece um calombo do outro lado.
- Montagem: 1) os 4 insertos na moldura da frente; 2) a tela no encaixe, com os pininhos nos furos; 3) a moldura de trás por cima; 4) os 4 parafusos M3 pelas torres, apertando só até encostar.

## Quando imprimir, confira

1. Os 4 pininhos entram nos furos sem forçar. Se não entrarem, os furos não estão a 1 mm da borda (antes você tinha medido 89,5 × 50).
2. O vidro assenta no bolso e a placa fica um tiquinho para fora atrás.
3. A placa assenta firme nos 4 cantos, sem balançar, e as soldas não encostam no fundo do rebaixo.
4. De frente, toda a parte que acende aparece, com uma bordinha escura igual em volta. Ligue o mascote para ver.
5. Depois de parafusar, a tela fica firme, a moldura de trás não entorta e nada racha em volta dos insertos.
