minepedro/testes/hardware/caixa/teste-tela/teste-tela-verificacao.pdf

# Peça de teste da tela: verificação

Medido nos arquivos gerados. Vista por trás, como sai da impressora: os pinos da tela ficam à direita aqui.

FRENTE, A 1,3 mm: JANELA E INSERTOS

FRENTE, A 4,6 mm: VIDRO E REBAIXO DAS SOLDAS

40,8

2

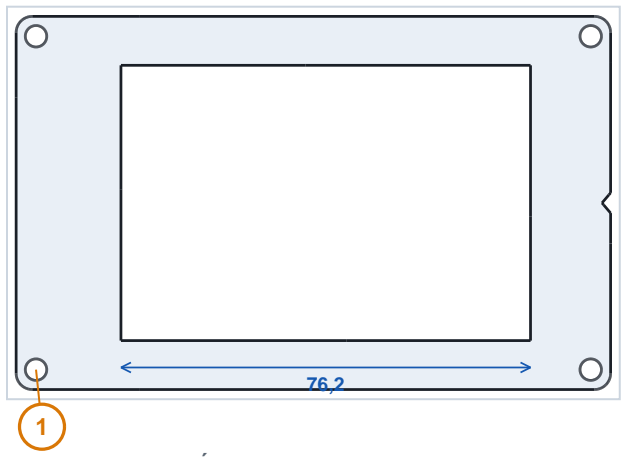
[picture p10: figure]

MOLDURA DE TRÁS, A 1,2 mm DA PLACA

3

MONTADO, PELO INSERTO DE CIMA (FRENTE EMBAIXO)

4

### 1 e 4. Insertos e parafusos

Furo de 4,0 por 6,2 nos 4 cantos, por fora da placa, com 0,8 de frente embaixo. O M3 de 19 entra pela torre da moldura de trás: a cabeça apoia a 13 mm da placa e a ponta para 0,4 antes do fundo.

### 2. Rebaixo das soldas

A placa apoia só nos 4 cantos (7 em cima e embaixo). O meio das duas faixas fica 2 mais fundo: as soldas do conector não encostam.

Pininhos
Quatro de 2,8 nos furos da tela, 90,4 x 49,2 entre centros. Alinham a placa; não seguram.

Encaixe e vidro
Encaixe da placa de -0,4 a 96,4 (96,8 x 55,4), com 0,4 de folga de cada lado. Bolso do vidro com 85, como nos testes em que o vidro entrou perfeito.

### 3. Moldura de trás

Aperta só os 4 cantos da placa, em cima dos furos; o meio fica livre para os componentes e o conector. Fica 0,2 acima da frente: o parafuso puxa e prende a placa.

Sólidos
Os dois fechados, uma casca cada. Montados, não se invadem.

Gerado por hardware/caixa/gerar_teste_tela.py. Imprimir sem suporte: a frente com a face da tela na mesa; a de trás com as torres para cima.
