minepedro/testes/(commit log)

2026-10-03 docs: decisão 2 (ESP32-S3 + ponte na VPS)
2026-10-03 docs: decisão 3 (fontes de sessões)
2026-10-03 docs: decisão 14 (sem teto de orçamento)
2026-10-03 docs: lista de compras (BOM) para Santa Ifigênia
2026-10-03 docs: guia de compras em PDF (marcas, lojas, preços estimados, ferramentas)
2026-10-03 docs: lista de compras online com links
2026-10-03 ui: protótipo web da tela (480x320) com mascote animado e push-to-talk
    Estados idle, listening, thinking e speaking numa grade de 12 px,
    pensado para virar sprites no LVGL depois.
    Claude-Session: https://claude.ai/code/session_01PC5vswkdjKx7tAHSVQQ8ss
2026-10-03 ui: sprite fiel ao Clawd do terminal (18x5, olhos e boca como buracos)
    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
2026-10-03 ui: remove a faixa de sombra que cortava o corpo do mascote
    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
2026-10-03 ui: mascote parado em todos os estados, sem anel ao ouvir, e tela de sessões
    Lista com ícone de estado, repo/branch, tempo e rolagem por arrasto;
    detalhe com última atividade e pedido de permissão pendente.
    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
2026-10-03 ui: sessão abre no mascote, aprovação, filtro por repo e nova sessão
    Mascote reage a pedido de permissão (alert) e mostra os botões
    Aprovar/Recusar na tela da sessão. Lista com filtro por repositório e
    formulário de nova sessão (repo + branch, ou avulsa). README documenta
    o que foi verificado sobre a conexão com o Claude Code.
    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
2026-10-03 ui: respostas só por texto, com leitura completa e histórico por sessão
    Decisão 16: sem voz de saída na v1. Alto-falante e amplificador
    passam a opcionais na lista de compras.
    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
2026-10-03 docs: guia de montagem real, mapa de pinos e lista de compras ajustada
    Mapa de pinos proposto para ESP32-S3 N16R8 (tela ST7796, touch I2C,
    microfone I2S), em etapas com um teste cada. Amplificador, alto-falante
    e capacitor passam para opcionais na lista online.
    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
2026-10-03 hardware: esquema visual das ligações; RESET e LED da tela vão para GPIO 6 e 7
    Todos os sinais ficam no conector esquerdo do ESP32-S3, o que simplifica
    a protoboard. Página com o caminho da conversa, o esquema com fios
    coloridos por barramento, explicação de cada grupo e checklist.
    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
2026-10-03 hardware: esquema da protoboard, lista de jumpers e etapas de teste com programas
    Vista de cima da protoboard por etapa, tabela dos 21 jumpers, lista do que
    ter na mesa e quatro programas de teste (compilam para ESP32-S3 N16R8,
    ainda não testados na placa).
    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
2026-10-04 hardware: desenhos e recomendações da caixa (cunha de duas peças)
    Três formatos comparados, vista de frente, corte lateral, layout interno
    por trás, recomendações de impressão para a Bambu A1 e lista do que medir
    quando as peças chegarem. Só desenho; medidas são propostas.
    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
2026-10-04 docs: decisão 17, caixa em cunha de duas peças (opção A)
    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
2026-10-04 hardware: página explicando visualmente cada componente da lista
    Mapa de todas as peças, caminho da energia, capacitor (com gráfico do que
    ele evita), resistor pull-up, botão tátil, barras de pinos e jumpers,
    protoboard por dentro, multímetro e ferramentas de solda.
    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
2026-10-04 Manual interativo de montagem na protoboard (Parte 1)
    40 passos em 4 etapas, peças e fios ligáveis/desligáveis, multímetro virtual
    calculado a partir do modelo de redes, previsão antes de medir, glossário,
    relatório 'Não bateu' e três vistas do circuito.
    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
2026-10-04 docs: avaliação do carrinho de compras
    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
2026-10-05 Manual interativo da placa ilhada (Parte 2) e extras de botão e som
    Placa 6x8 cm furo a furo: soquetes, barramentos, fios do verso, layout
    ajustável com avisos, defeitos simulados (ponte de solda), tabela final de
    continuidade. Extras desligados por padrão: botão (GPIO 21) e som
    (MAX98357A, capacitor, alto-falante), com programas de teste que compilam.
    Decisão 19. Parte 1 passa a linkar a Parte 2.
    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
2026-10-05 Parte 1 do manual: extras de capacitores, pull-ups, botão e som
    Quatro extras opcionais (desligados por padrão) na protoboard: capacitores
    de 100 nF, pull-ups de 4,7 kΩ no touch, botão (GPIO 21) e som (MAX98357A,
    470 µF, alto-falante). Multímetro virtual ganha o modo resistência (Ω) e o
    botão 'segurando'. Corrige o estilo do selo 'opcional' nas duas partes.
    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
2026-10-08 hardware: manual e esquema para a tela de teste ILI9488 com touch resistivo
    Touch XPT2046 em SPI próprio (SPI3) nos GPIO 9, 5, 8 e 4; T_IRQ sem ligar.
    Programa etapa2_3_tela_touch_ili9488 compila para ESP32-S3 (não testado na placa).
    Claude-Session: https://claude.ai/code/session_01SxboiigKorMT1wVqrHMahG
2026-10-08 hardware: rascunho da placa-base (PCB) do modelo final
    Esquema com rótulos de rede, posição das peças em 80 x 60 mm, redes, peças
    e regras para desenhar no EasyEDA. O conector da tela serve para a ST7796 e
    para a ILI9488 (pinos 10 a 13 nos mesmos GPIO).
    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
2026-10-11 docs: etapa 3 aprovada (touch resistivo)
    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
2026-10-11 firmware: demo do mascote na tela (ILI9488 + touch resistivo)
    Sprite, cores e estados do protótipo web: repouso, ouvindo, pensando,
    respondendo, trabalhando e alerta. Segurar a tela = ouvir; soltar = resposta
    de exemplo. Compila para ESP32-S3; não testado na placa.
    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
2026-10-11 ponte demo e firmware do mascote com lista de sessões e aprovação
    - software/bridge/ponte.py: API HTTP com token; sessões de exemplo que pedem
    permissão sozinhas; serviço systemd para a VPS.
    - firmware/mascote: Wi-Fi, tarefa de rede no núcleo 0, telas mascote, lista e
    sessão, botões Aprovar e Recusar. Compila para ESP32-S3; não testado na placa.
    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
2026-10-11 bridge/cli: prototipo de laboratorio da ponte e hook do mascote (fase 1)
2026-10-11 bridge/cli: testes reais de sempre permitir, perigoso e plano
2026-10-11 bridge/cli: hook para de esperar quando o pedido e respondido pelo app
2026-10-11 bridge/cli: registra teste real de resposta pelo app primeiro
2026-10-12 bridge/real: troca de producao confere token e HTTPS e volta sozinha para a demo se falhar
2026-10-12 mascote: voz (gravar, transcrever, confirmar), nova sessao por repo/branch e filtro de sessoes por repo
    Segurar a area de fala grava o INMP441; ao soltar manda o audio para /api/voz e
    mostra o texto para confirmar. Na sessao vira mensagem; na tela inicial vira a
    tarefa de uma sessao nova (escolhe repo e branch). A lista ganha o filtro por repo
    e o botao + para sessao nova.
    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
2026-10-12 deploy-https: nginx repassa /api/ inteiro e /api/voz com 1 MB e 90 s; script de atualizacao com backup
2026-10-12 docs: Camarim do mascote (prévia de acessórios e animações), prompt para o firmware e decisão 27
    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
2026-10-12 mascote: teste de host que desenha quadros do Camarim com o codigo do firmware
2026-10-12 hardware: manual da placa ilhada para a tela de teste ILI9488
    Mesma placa da ST7796: os fios do touch XPT2046 (T_CLK, T_CS, T_DIN, T_DO) vão nos
    mesmos furos e GPIO (9, 5, 8, 4) do touch capacitivo. Troca o programa de teste,
    os nomes dos pinos e o passo do scanner I2C (que não serve para o XPT2046).
    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
2026-10-12 hardware: manual visual da placa ilhada (ILI9488) e guia do barramento
    Passo a passo com desenho da placa em cada etapa (frente ou verso), tabela de fios
    com furo de saída, chegada, cor e tamanho, testes de multímetro e os programas de teste.
    Mesmo layout do manual interativo da placa ilhada.
    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
2026-10-12 hardware: manual visual da placa com microfone redondo (2x3), frente e verso em cada passo e jumpers da tela
    O INMP441 redondo usa dois soquetes de 3 pinos; distância entre as fileiras e ordem
    dos nomes são ajustáveis no manual e recalculam furos, desenhos e tamanhos de fio.
    Cada passo mostra a placa inteira de frente e de verso. A ligação da tela tem desenho
    próprio, jumper por jumper, com tabela.
    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
2026-10-12 hardware: close da solda do fio no manual visual da placa
    Passo novo com a ponta do fio (descascar e estanhar), a solda no pino do soquete
    vista de lado e de cima, a chegada no barramento e três erros comuns.
    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
2026-10-12 hardware: manual visual da placa refeito para placa de 6x8 cm (25x20 furos)
    ESP32 nas linhas 10 e 19 (colunas 3 a 24), tela na linha 6 (colunas 5 a 17),
    microfone à direita (coluna 19), barramentos nas linhas 2 e 8.
    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
2026-10-12 hardware: manual visual na placa de 27x22 furos (linhas A-V) e ESP32 com USB à esquerda
    O desenho anterior punha a fileira J1 em cima com a antena à esquerda, o que só
    acontece com o ESP32 de cabeça para baixo. Agora: antena à direita, USB à esquerda,
    J1 em cima (GND ... 3V3 da esquerda para a direita). Furos nomeados como na placa
    (letra da linha + número da coluna).
    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
2026-10-12 hardware: manual visual com o ESP32 soldado nas linhas B e L (colunas 2 a 23)
    Pedro soldou o soquete do ESP32 com J1 (3V3...GND) na linha L e J3 na linha B,
    10 furos de distância e USB perto da coluna 2. A placa é desenhada com a letra A
    embaixo, como ele vê. Tela (linha Q), microfone (Q a S), barramentos 3V3 (U) e
    GND (N) ficam acima da fileira de sinais.
    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
2026-10-12 hardware: microfone com vão de 2 furos entre as fileiras (colunas 1 e 4)
    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
2026-10-12 hardware: barramento com fio nu curto (emendas em furos de solda)
    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
2026-10-12 hardware: passo dos capacitores no manual visual (100 nF no microfone e na tela, eletrolítico opcional)
    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
2026-10-12 hardware: tutorial visual dos capacitores no manual da placa
    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
2026-10-12 hardware: capacitores na frente (furos ao lado dos pinos) com ponte de estanho no verso
    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
2026-10-12 hardware: close de como fazer a ponte de estanho (perna do capacitor ao pino)
    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
2026-10-12 hardware: tutorial do barramento com medidas de corte, emendas e pontos de solda
    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
2026-10-15 ponte: tmux proprio (-L mascote, units mascote-tmux/mascote-rc), reabertura de sessoes e hook sem espera com aparelho offline
2026-10-15 ponte: regra de perigosos so nas sessoes criadas pelo mascote (decisao 23 revisada)
2026-10-17 hardware: passos do som no manual visual (amplificador MAX98357A e alto-falante)
    Parte nova "Som (opcional)" no fim do manual, sem mudar a numeração dos passos 1 a 28:
    preparar o amplificador, teste na protoboard com o extra_som, 5 fios da placa até o
    amplificador (jumpers com a ponta macho soldada em L3, L2, L13, L15 e L16) e teste final
    com o capacitor de 470 µF. A caixa "Confira" passa a mostrar o texto corrido.
    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
2026-10-17 hardware: amplificador encaixa por jumpers num soquete de 5 (linha S)
    Em vez de cortar e soldar os jumpers no verso, o manual agora põe um soquete de 5 na
    linha S, colunas 12 a 16 (fora do caminho dos fios do verso e a 2 linhas do barramento
    3V3), com 5 fios até L15, L16, L13, N10 e L3. O amplificador liga por 5 jumpers
    macho-fêmea na mesma ordem dos pinos dele, como a tela. Passos 29 a 33.
    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
2026-10-17 hardware: soquete do amplificador na coluna 26 (R26 a V26)
    A linha S ficava apertada entre o soquete da tela e o barramento 3V3. O soquete de 5
    vai em pé no canto livre da coluna 26, longe dos fios do verso e da antena; os fios
    do verso continuam indo para L15, L16, L13, N10 e L3.
    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
2026-10-17 hardware: GND do amplificador no pino GND do ESP32 (B23)
    O fio sai do U26 e desce pela borda até o B23, sem atravessar o meio da placa. Assim a
    corrente do alto-falante volta direto ao ESP32 e não passa pelo barramento GND onde
    está o microfone.
    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
2026-10-17 hardware: close de onde soldar o capacitor de 470 µF no amplificador
    No passo final do som, o capacitor aparece num close visto de cima e de lado: deitado
    em cima do amplificador, pernas nas bolinhas de solda dos pinos GND (faixa clara) e
    VIN. O teste vem primeiro; o capacitor entra se aparecerem estalos.
    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
2026-10-17 hardware: soquete do amplificador na coluna 27 e capacitor de 470 µF na placa
    O soquete de 5 vai para a borda (R27 a V27) e libera a coluna 26 para o C4: o
    capacitor de 470 µF fica deitado na frente, pernas em U26 (−) e V26 (+), com gotas
    de estanho no verso até o GND (U27) e o VIN (V27) do soquete. O close mostra frente,
    verso e o capacitor de lado.
    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
2026-10-18 hardware: como soldar os fios no alto-falante (passo 33)
    Desenho do alto-falante por trás com as duas abas, os fios trançados até o conector
    verde e a cola quente segurando os fios. Passo a passo da solda rápida na aba, aviso
    de que nenhum fio do alto-falante vai no GND (saída em ponte do MAX98357A) e o teste
    logo depois.
    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
2026-10-18 hardware: ponte IN-OUT do ESP32 para o 5Vin alimentar o amplificador
    Na placa YD o pino 5Vin só recebe energia (diodo no caminho); para entregar os 5 V do
    USB ao amplificador é preciso fechar a ponte IN-OUT. O passo 30 agora mede o 5Vin e,
    se der 0 V, ensina a fazer a ponte. Também corrige o contraste dos blocos de código
    (o estilo do código em linha vazava para dentro deles).
    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
2026-10-18 docs: como usar a entrada USB do ESP32 quando a COM para de dar energia
    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
2026-10-18 firmware: DIN do amplificador em 0 para não chiar com o microfone ligado
    O MAX98357A divide o SCK e o WS com o INMP441. Com o microfone gravando, esses relógios
    ficam ligados o tempo todo e o amplificador lê o DIN (GPIO 18) solto como som, o que vira
    chiado. O mascote agora deixa o GPIO 18 em 0 desde o início. Compila para o ESP32-S3
    N16R8 (esp32 3.3.12), também com USB CDC On Boot ligado.
    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
2026-10-19 Peça de teste da tela para a caixa Mini Mac
    Moldura com a janela da parte que acende, bolso do vidro, encaixe da placa
    vermelha e 4 pininhos nos furos da tela. Script gerador e arquivos
    STEP, 3MF e o PDF de verificação medido no arquivo.
    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
2026-10-19 Teste da tela: insertos M3 e moldura de trás
    Furos da tela a 1 mm da borda (90,4 x 49,2) e pininhos de 2,8. Insertos
    M3 nos cantos da moldura da frente, por fora da placa, e uma moldura de
    trás que aperta os cantos da placa com 4 parafusos M3 x 19 (torres para
    a ponta não furar a frente). STEP de cada peça, 3MF com as duas e PDF de
    verificação.
    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
2026-10-19 Caixa Mini Mac: medidas, páginas e decisão no repositório
    hardware/caixa: README com arquivos, decisões e pendências; medidas.json
    com as medidas tiradas no paquímetro; a página de medidas (abre já com
    elas), as ideias de caixa, o croqui do teste da tela e o script que mede
    os STEP e refaz o PDF. Mapa do ESP32 em hardware/. Decisão 28 em
    docs/decisoes.md (Mini Mac no lugar da cunha).
    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
2026-10-19 Planta da caixa Mini Mac em escala
    Frente, corte de lado, vista de cima e lateral direita com a tela, a
    placa ilhada (linha V para a frente, USB na lateral direita), o alto-
    falante no topo e o queixo com LED, microfone e botão. Proposta para
    confirmar antes de modelar.
    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
2026-10-19 Teste da tela: bolso do vidro 1 mm maior à esquerda
    O primeiro teste impresso pediu 1 mm a mais do lado esquerdo (o dos
    pinos): o bolso do vidro agora vai de 4,7 a 90,7. Peças, croqui e PDF de
    verificação gerados de novo. A página de medidas ganhou o plugue do cabo
    USB-C e a posição do USB na placa, para a entrada embutida na lateral.
    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
2026-10-19 Teste da tela, 2ª versão: encaixe da placa 1 mm maior à esquerda
    No primeiro teste impresso o vidro, os pininhos e a janela ficaram
    certos; a placa vermelha não entrou do lado esquerdo (o dos pinos). O
    encaixe da placa passa a 97,6 de largura, com o 1 mm a mais à esquerda,
    e o vão da moldura de trás acompanha. Por garantia, o bolso do vidro
    também ganha 1 mm à esquerda (86,0). A verificação mede a parede entre
    o encaixe e o furo do inserto (2,0) e a borda de fora (1,8).
    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
2026-10-19 Teste da tela: bolso do vidro como era, encaixe da placa +2 mm à esquerda
    O vidro tinha entrado perfeito no primeiro teste: o bolso volta a 85,0
    (5,7 a 90,7). O encaixe da placa vermelha fica 2 mm maior do lado
    esquerdo (98,6 de largura), 1 mm que faltou e 1 de garantia; o vão da
    moldura de trás acompanha. Parede até o furo do inserto: 1,5.
    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
2026-10-19 Teste da tela: encaixe da placa 1 mm maior de cada lado
    A placa vermelha precisa de 1 mm a mais à esquerda e 1 mm a mais à
    direita (encaixe de 98,6, de -1,3 a 97,3); o vão da moldura de trás
    acompanha. O bolso do vidro continua como no primeiro teste (85,0).
    Parede até os furos dos insertos: 2,0.
    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
2026-10-19 Caixa Mini Mac v1: corpo, bandeja, moldura da tela, tecla e tampa do mic
    gerar_caixa.py modela a caixa inteira em cima das medidas do teste da tela:
    USB-C embutido na lateral, bandeja que entra por trás em trilhos, trilhos do
    amplificador, copo do microfone, aletas do alto-falante e batentes dos
    parafusos de trás com rampa a 45° para imprimir com a frente na mesa.
    verificar_caixa.py confere peças fechadas, colisões com as peças reais, a
    bandeja entrando, o alcance da chave de fenda e o comprimento dos parafusos,
    e gera o modelo da página 3D. Plugue, J e amplificador ainda são chute.
    Claude-Session: https://claude.ai/code/sessio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
2026-10-19 Teste da tela v3: placa apoia só nos cantos, rebaixo para as soldas
    As soldas do conector, na frente da placa do lado dos pinos, batiam na faixa
    de apoio; a largura não era o problema. O meio das duas faixas fica 2 mm mais
    fundo (a placa apoia em 7 mm em cima e embaixo) e o encaixe volta a ter 0,4
    de folga de cada lado (96,8). A caixa recebe o mesmo, e a verificação dela
    passa a ter as soldas como peça de referência.
    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
